dohyunKim0309/CNN_Accelerator/docs/address_map_winograd.png

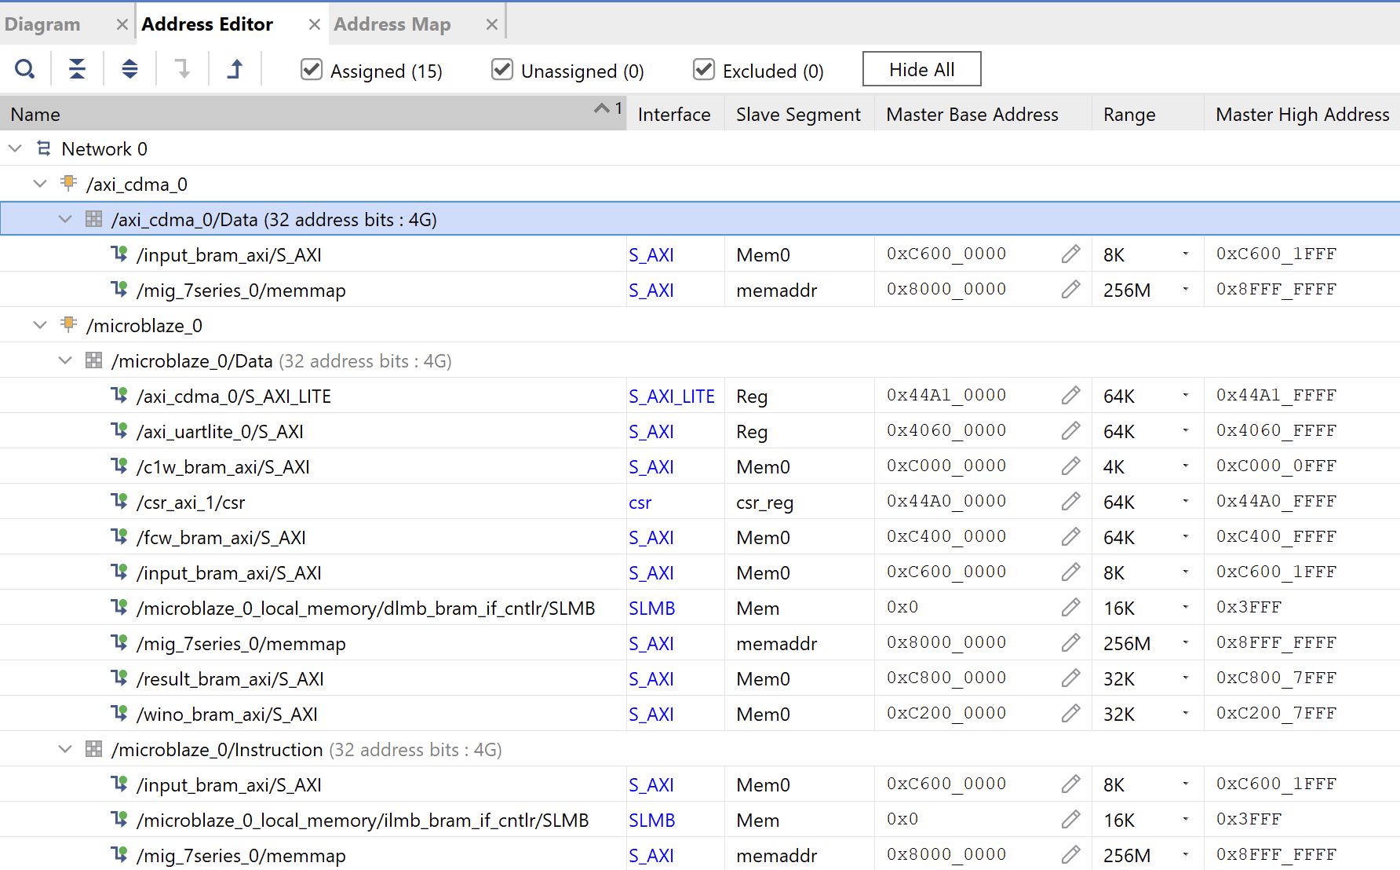
docs/address_map_winograd.png
