dohyunKim0309/CNN_Accelerator/docs/codebase_capture.png

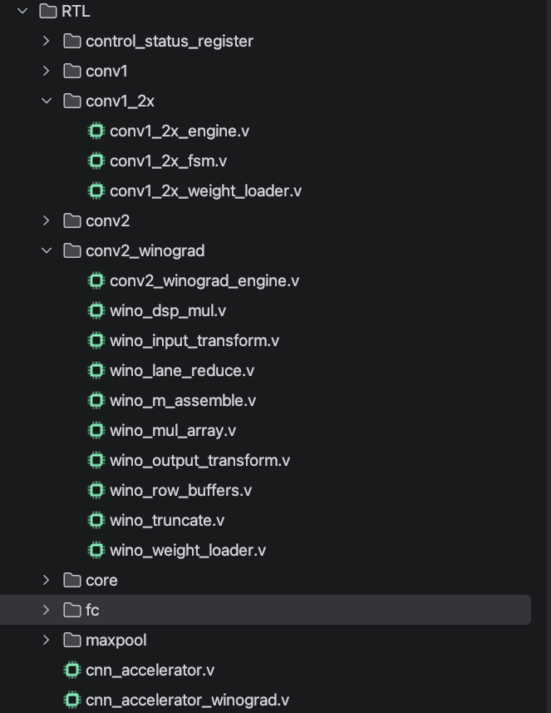
docs/codebase_capture.png
