dohyunKim0309/CNN_Accelerator/docs/ip_spec/wino_weight_bram/wino_weight_bram-basic.png

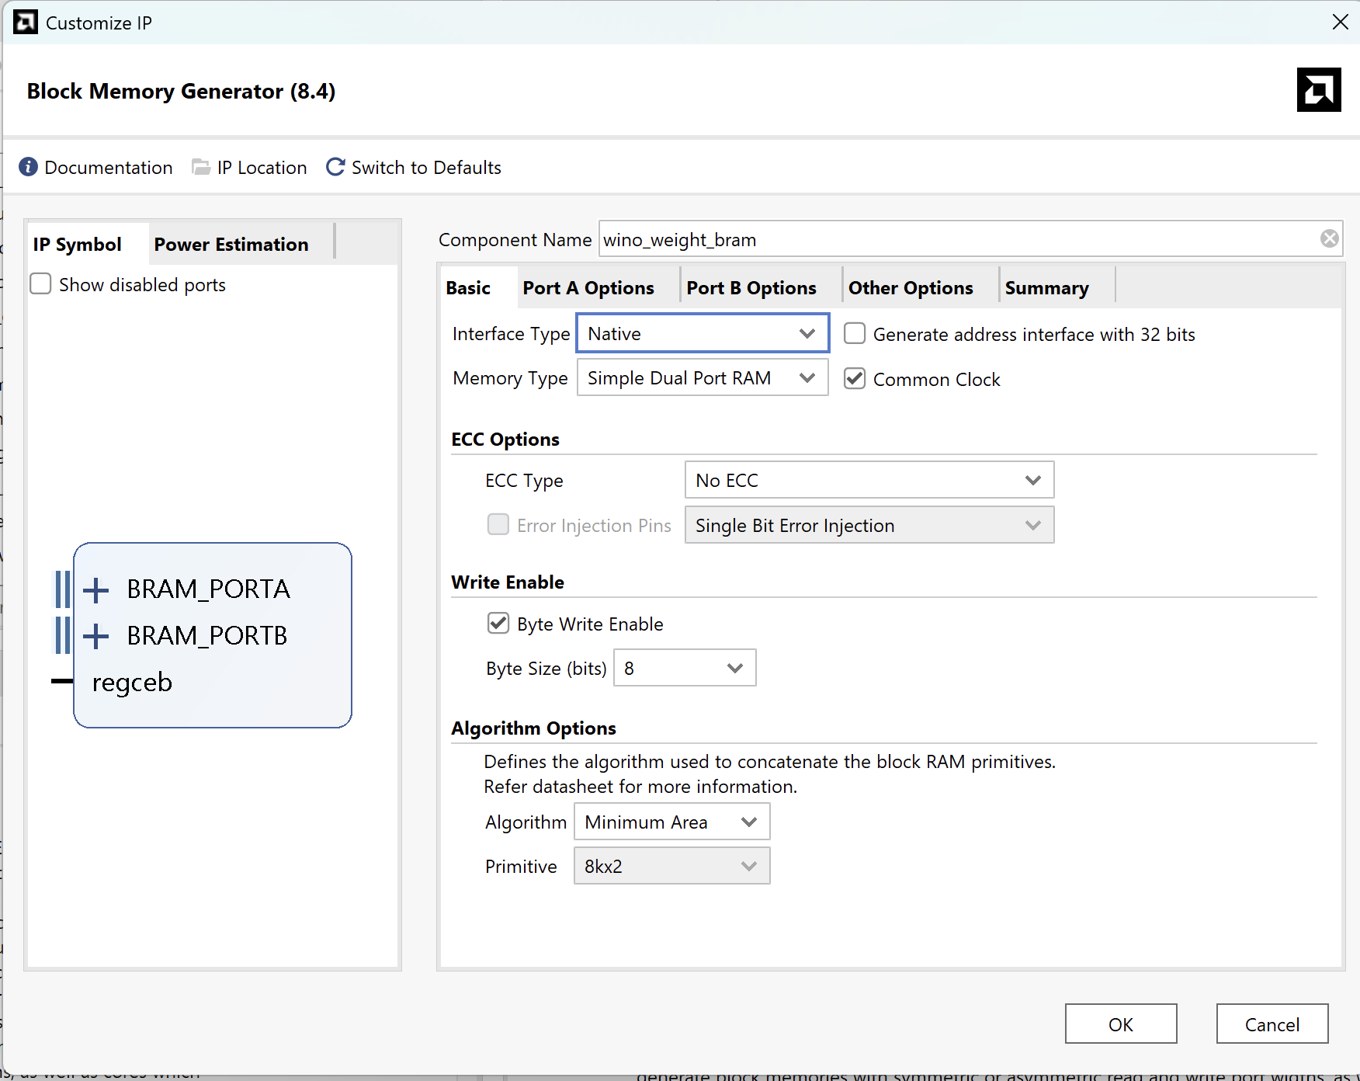
docs/ip_spec/wino_weight_bram/wino_weight_bram-basic.png
