dohyunKim0309/CNN_Accelerator/docs/ip_spec/wino_weight_bram/wino_weight_bram-portB.png

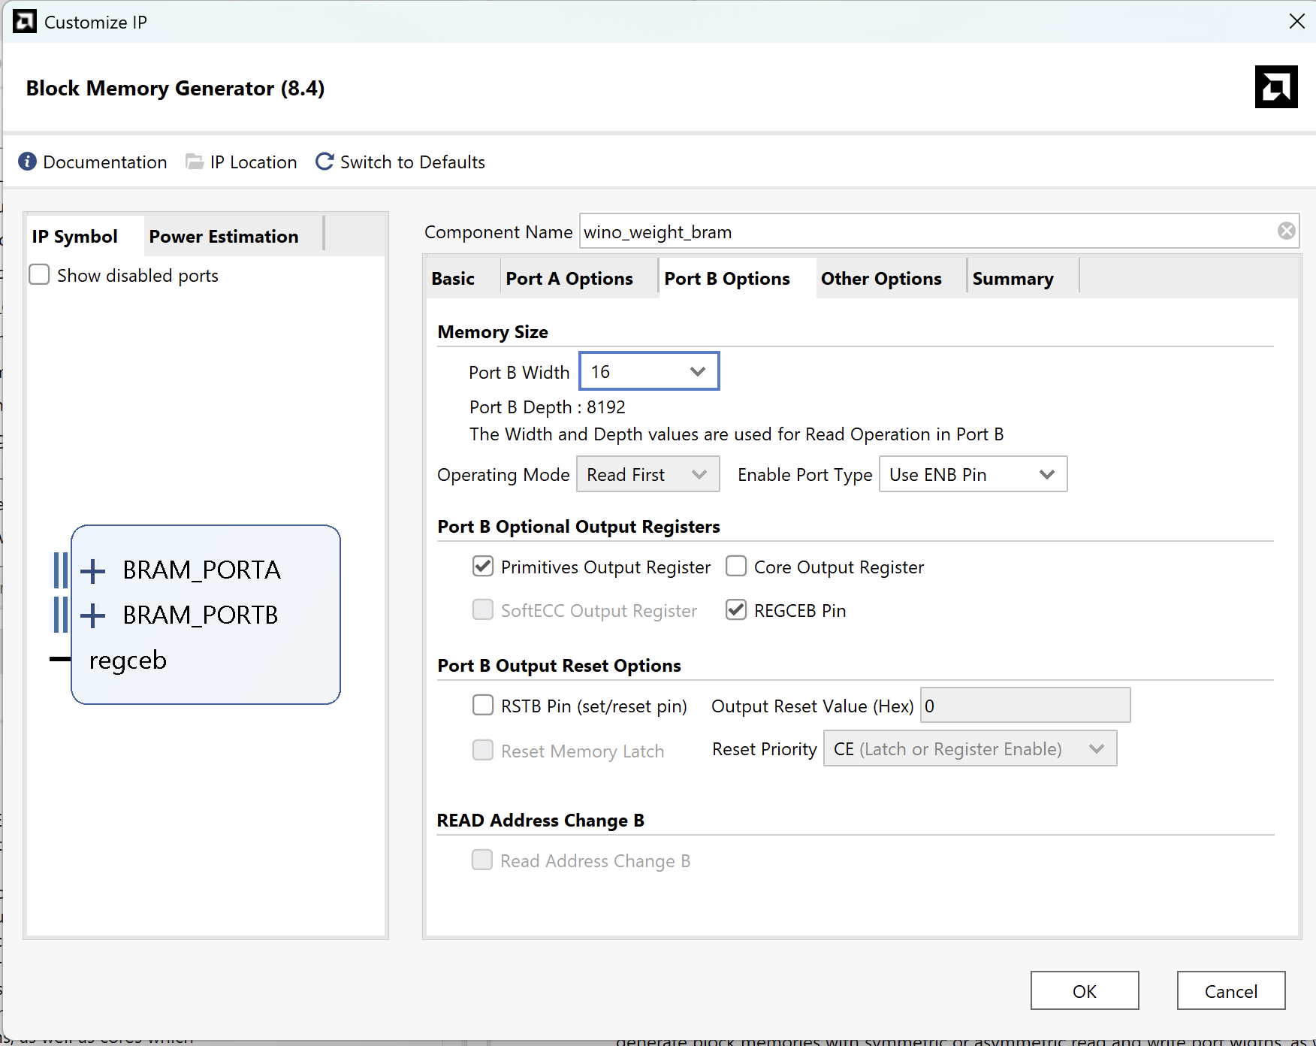
docs/ip_spec/wino_weight_bram/wino_weight_bram-portB.png
