dohyunKim0309/CNN_Accelerator/docs/MIG.png

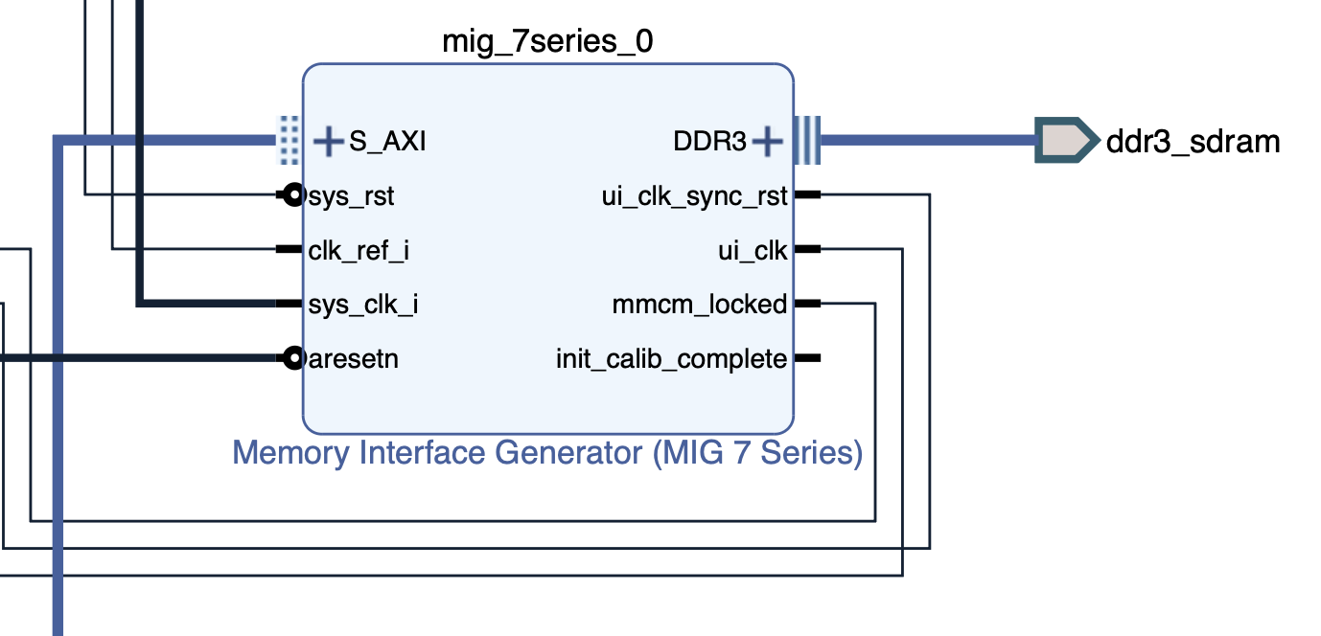
docs/MIG.png
