dohyunKim0309/CNN_Accelerator/docs/overclock/direct/timing/150_timing.png

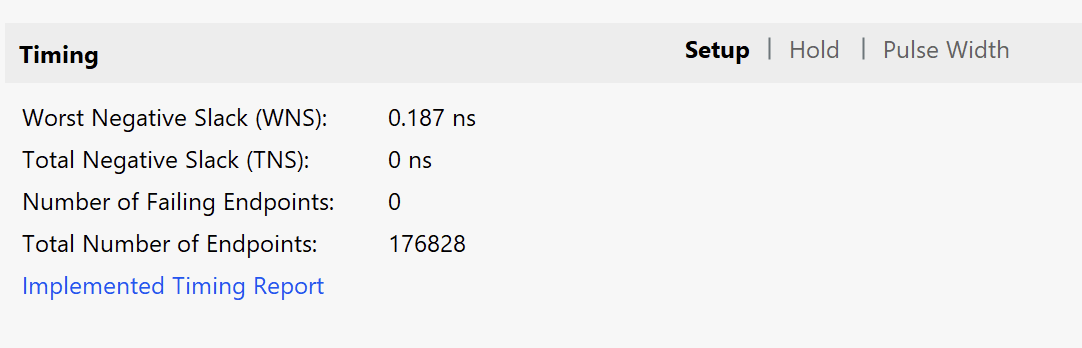
docs/overclock/direct/timing/150_timing.png
