dohyunKim0309/CNN_Accelerator/docs/overclock/direct/timing/final_power.png

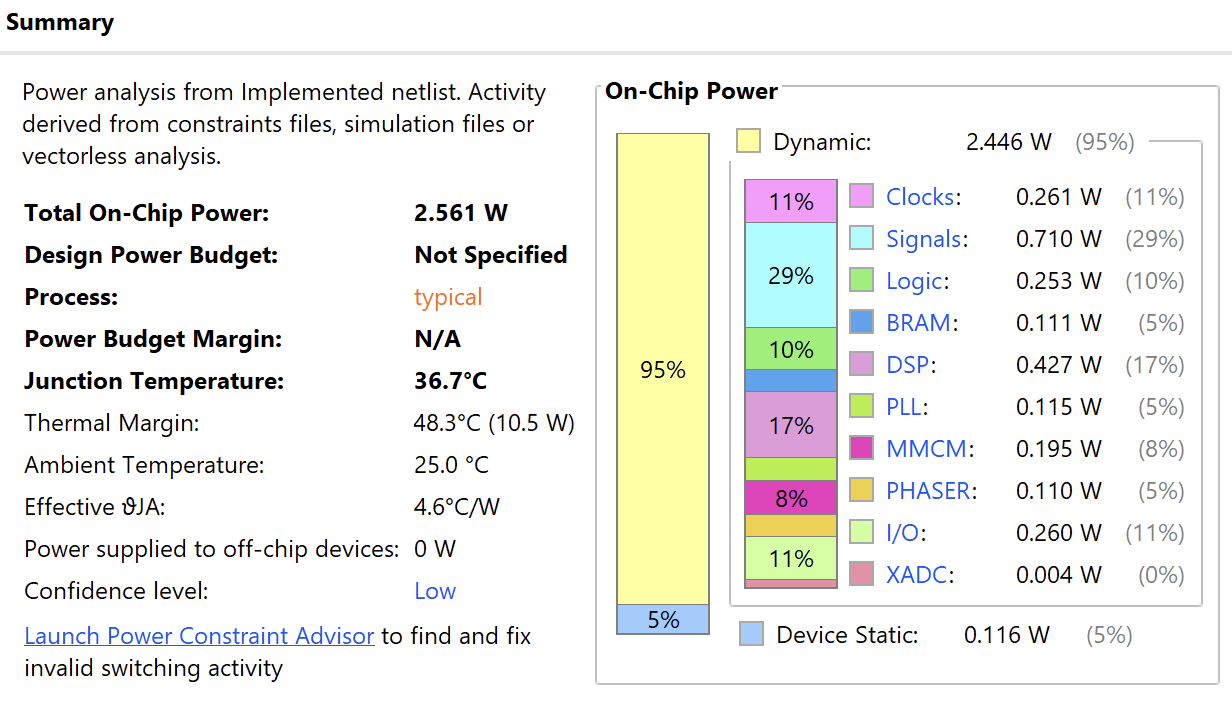
docs/overclock/direct/timing/final_power.png
