dohyunKim0309/CNN_Accelerator/docs/overclock/direct/timing/final_timing.png

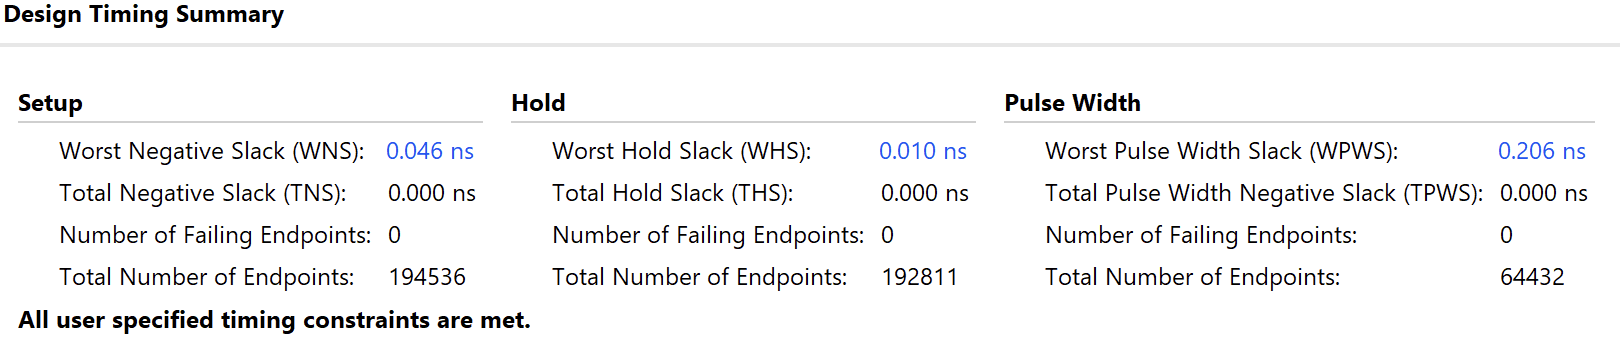
docs/overclock/direct/timing/final_timing.png
