dohyunKim0309/CNN_Accelerator/docs/overclock/winograd/03_route_wns-1.74_output-transform/스크린샷 2026-06-12 오전 12.46.09.png

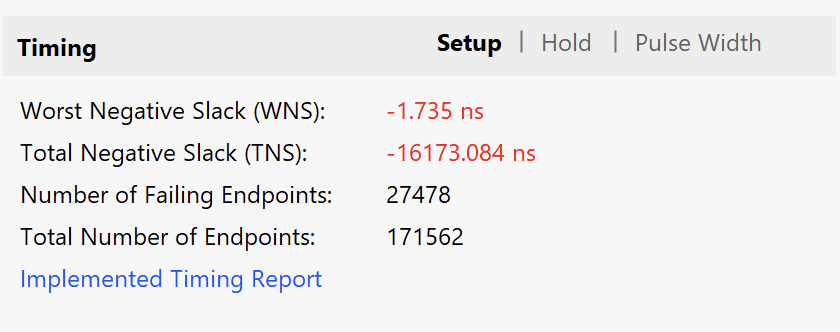
docs/overclock/winograd/03_route_wns-1.74_output-transform/스크린샷 2026-06-12 오전 12.46.09.png
