dohyunKim0309/CNN_Accelerator/docs/overclock/winograd/04_route_wns-0.41_wm-equiv-merge/스크린샷 2026-06-12 오전 2.36.51.png

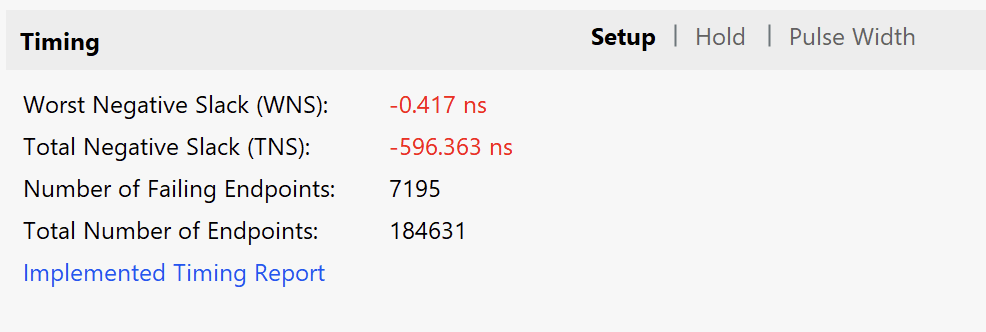
docs/overclock/winograd/04_route_wns-0.41_wm-equiv-merge/스크린샷 2026-06-12 오전 2.36.51.png
