dohyunKim0309/CNN_Accelerator/docs/overclock/winograd/winograd_171.42MHz_timing.png

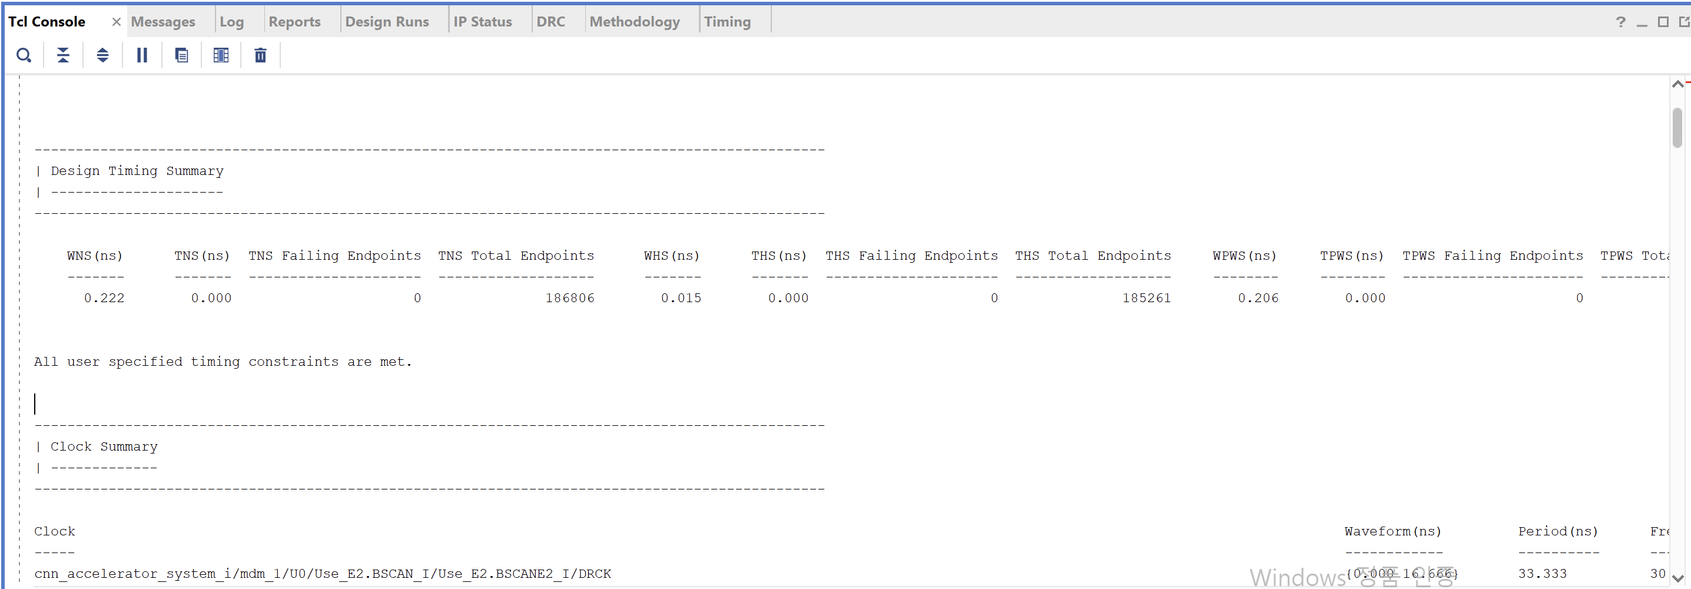
docs/overclock/winograd/winograd_171.42MHz_timing.png
