dohyunKim0309/CNN_Accelerator/docs/presentation_timing/01_trap.png

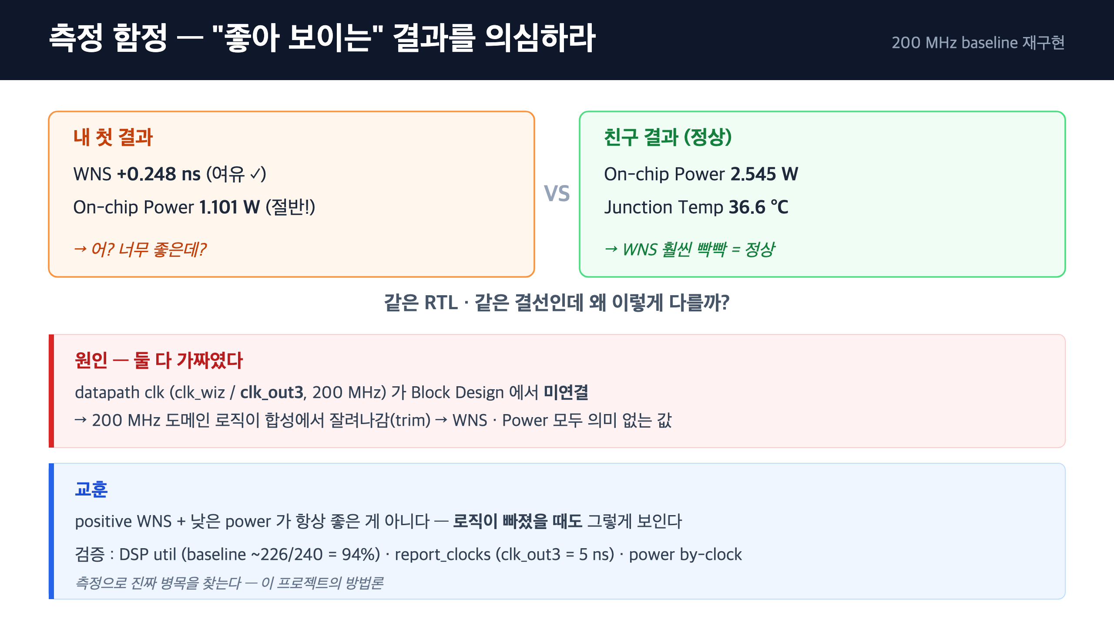
docs/presentation_timing/01_trap.png
