dohyunKim0309/CNN_Accelerator/docs/presentation_timing/02_bottleneck.png

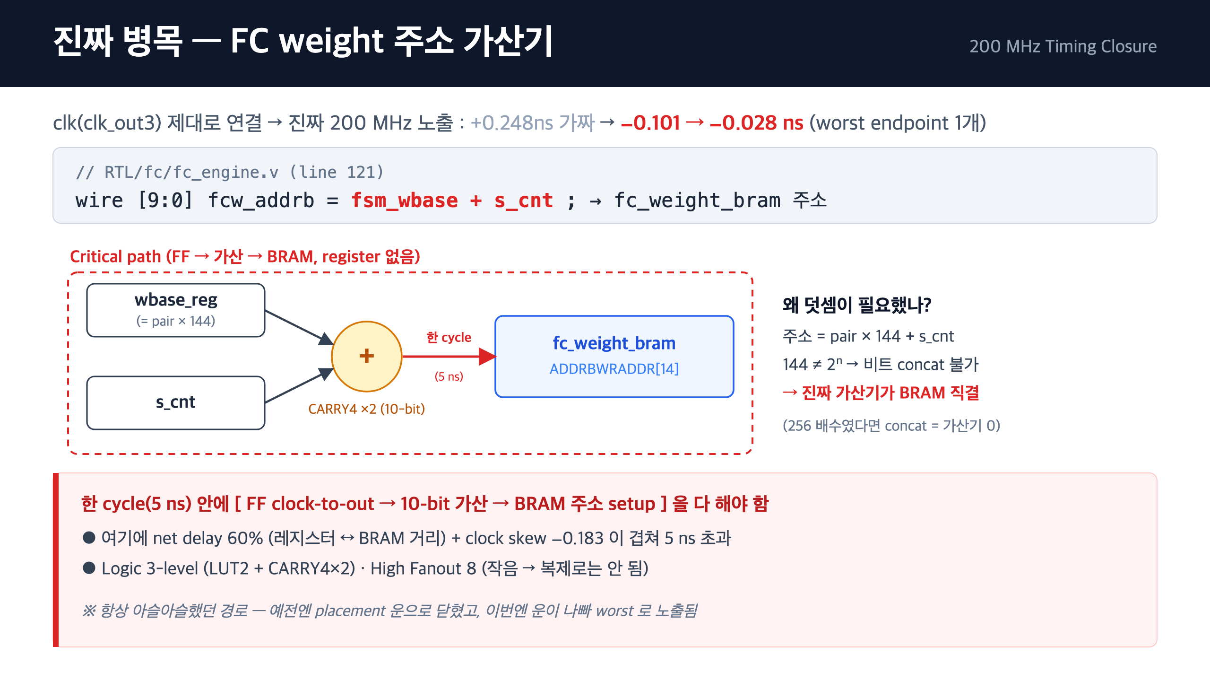
docs/presentation_timing/02_bottleneck.png
