dohyunKim0309/CNN_Accelerator/docs/UART_우회_DDR3.png

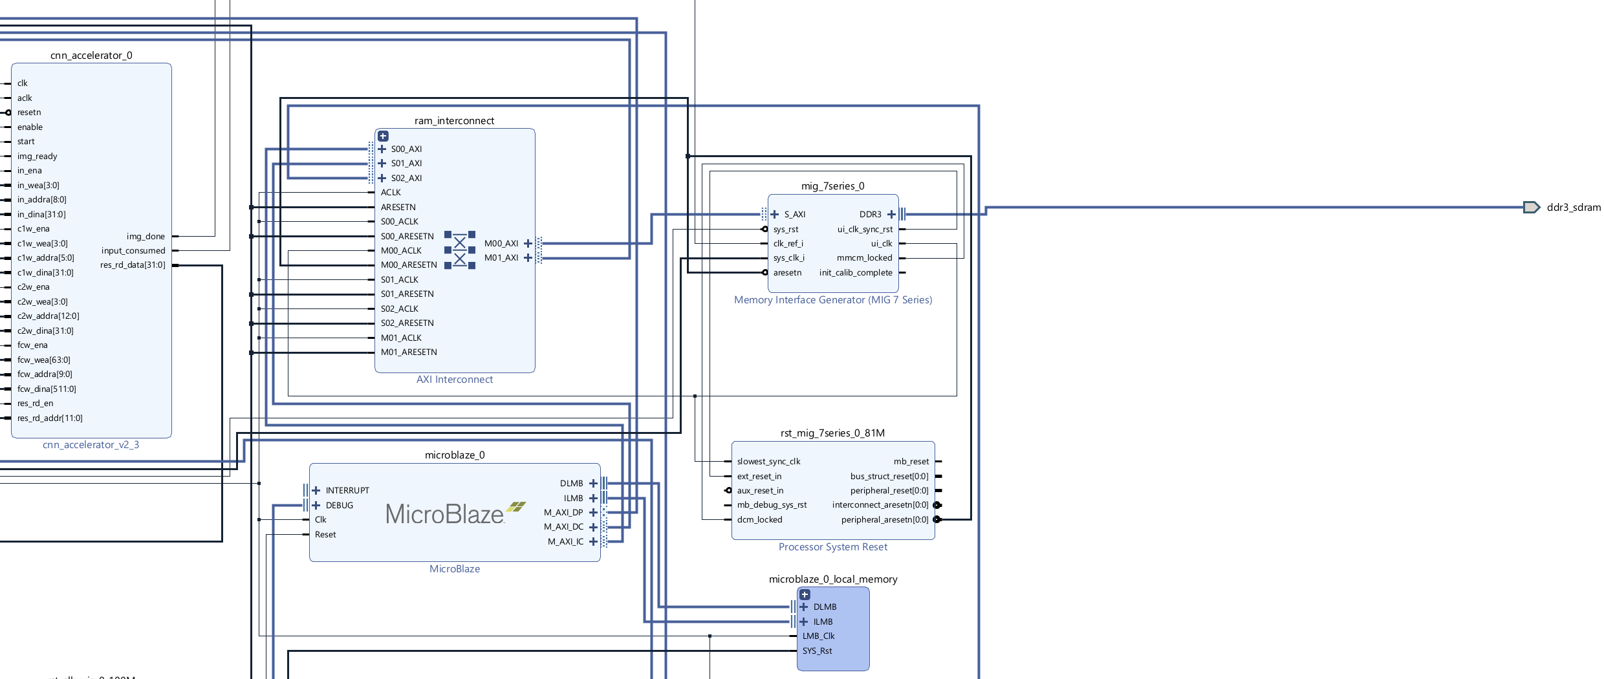
docs/UART_우회_DDR3.png
