dohyunKim0309/CNN_Accelerator/docs/winograd_utilization_stale.png

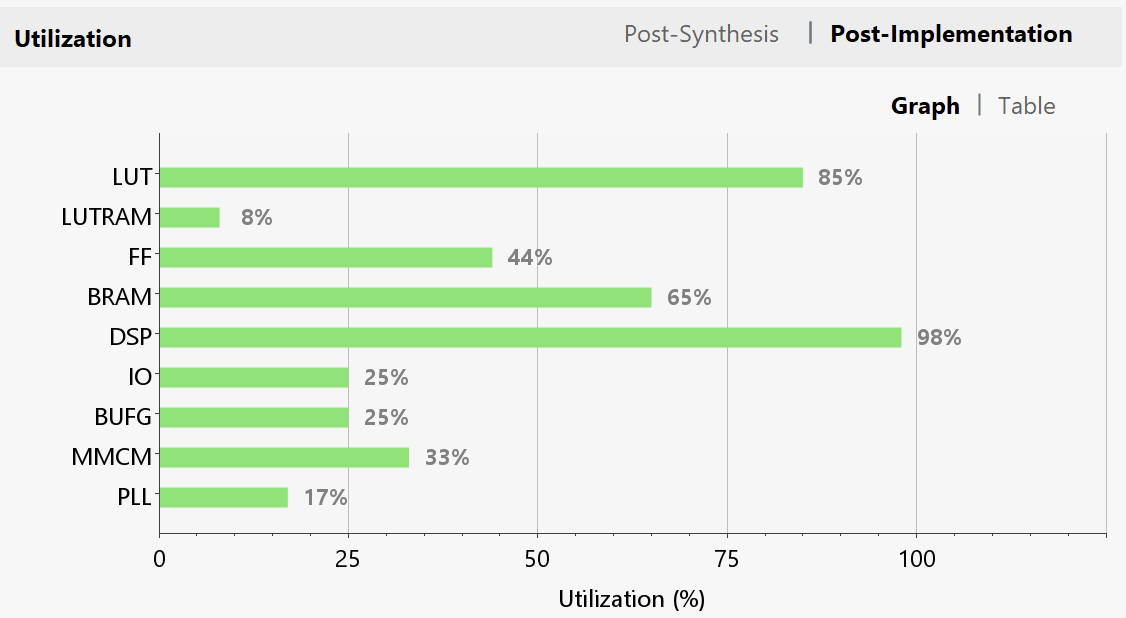
docs/winograd_utilization_stale.png
