dohyunKim0309/CNN_Accelerator/docs/result_01_sequential.png

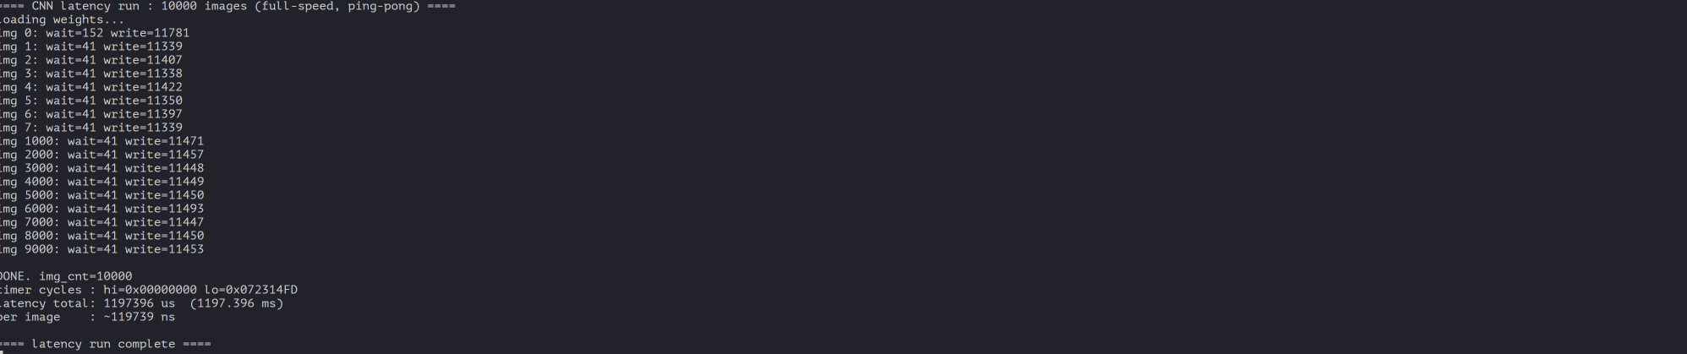
docs/result_01_sequential.png
