dohyunKim0309/CNN_Accelerator/docs/result_02(2)axi_burst.png

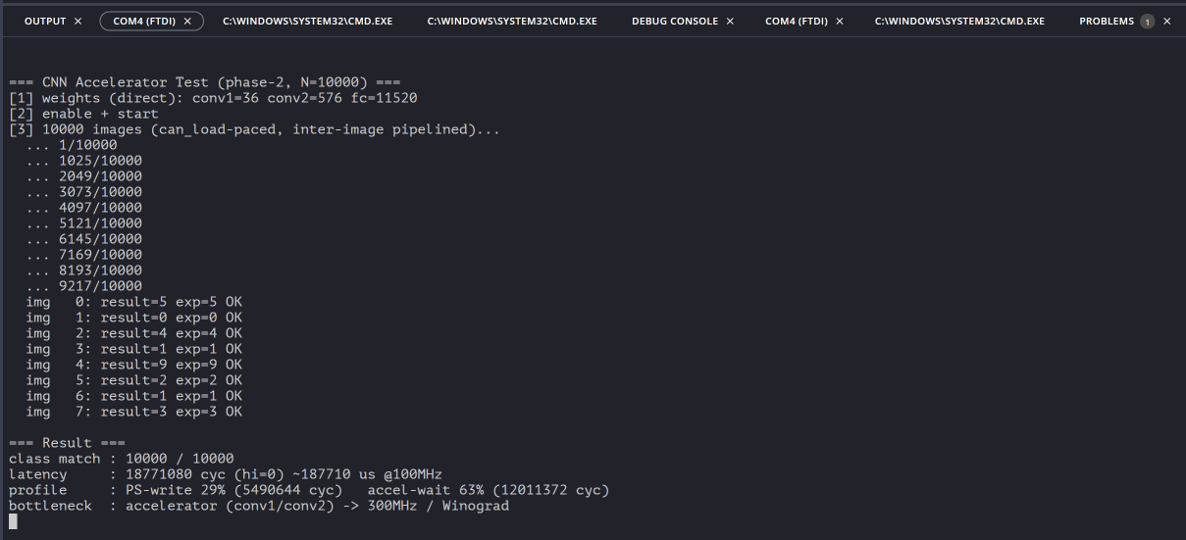
docs/result_02(2)axi_burst.png
