dohyunKim0309/CNN_Accelerator/docs/result_02_pipelining.png

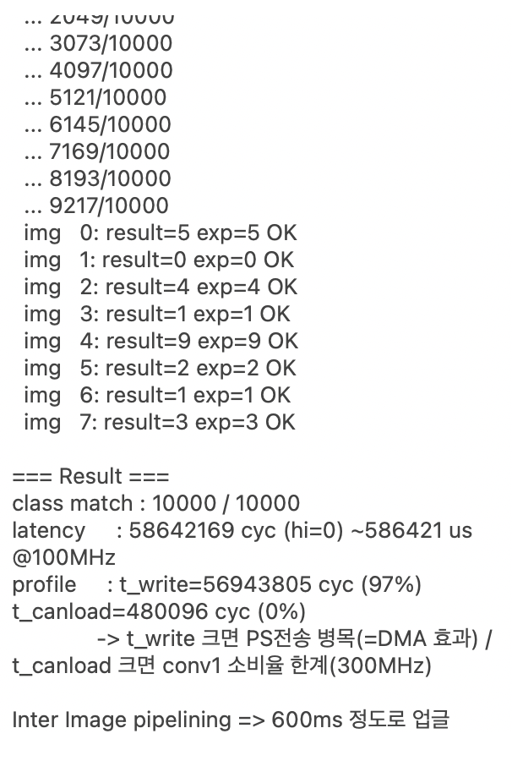
docs/result_02_pipelining.png
