dohyunKim0309/CNN_Accelerator/RTL/conv2_winograd/wino_input_transform.v

`timescale 1ns / 1ps
////////////////////////////////////////////////////////////////////////////////
// wino_input_transform.v  (자동생성: scripts/weights/winograd_gen.py)
//   복소수 Winograd F(4,3) 입력변환  V = Bᵀ·d·B  (per IC, 곱셈기 0개)
//   d(6×6 INT8) → 46 activation operand (B-port feed), canonical 순서:
//     [16 real pos: V_re] + [10 cmul pos: (V_re+V_im), V_re, V_im]
//   ★ 3-stage PIPELINE: stage1 t=Bᵀ·d → reg → stage2a 부분합 → reg →
//     stage2b 최종합+assembly.  a_flat = d_flat + 2 cycle (engine 정렬 +4 기준).
//   계수 {0,±1,±4} add/shift/neg only.
////////////////////////////////////////////////////////////////////////////////
module wino_input_transform #(parameter DW=8, VW=14) (
    input  wire             clk,
    input  wire [36*DW-1:0] d_flat,   // d[k][l] = d_flat[(k*6+l)*DW +: DW] (signed)
    output wire [46*VW-1:0] a_flat    // operand i = a_flat[i*VW +: VW] (signed, +2 cyc)
);
    wire signed [10:0] d [0:5][0:5];
    genvar gk, gl;
    generate for (gk=0; gk<6; gk=gk+1) for (gl=0; gl<6; gl=gl+1)
        assign d[gk][gl] = $signed(d_flat[(gk*6+gl)*DW +: DW]);
    endgenerate

    // stage1 (comb): t = Bᵀ·d   t[p][l] = Σ_k Bᵀ[p,k]·d[k][l]
    wire signed [10:0] tre_c [0:5][0:5];
    wire signed [10:0] tim_c [0:5][0:5];
    assign tre_c[0][0] = (d[0][0] <<< 2) - (d[4][0] <<< 2);
    assign tim_c[0][0] = 11'sd0;
    assign tre_c[0][1] = (d[0][1] <<< 2) - (d[4][1] <<< 2);
    assign tim_c[0][1] = 11'sd0;
    assign tre_c[0][2] = (d[0][2] <<< 2) - (d[4][2] <<< 2);
    assign tim_c[0][2] = 11'sd0;
    assign tre_c[0][3] = (d[0][3] <<< 2) - (d[4][3] <<< 2);
    assign tim_c[0][3] = 11'sd0;
    assign tre_c[0][4] = (d[0][4] <<< 2) - (d[4][4] <<< 2);
    assign tim_c[0][4] = 11'sd0;
    assign tre_c[0][5] = (d[0][5] <<< 2) - (d[4][5] <<< 2);
    assign tim_c[0][5] = 11'sd0;
    assign tre_c[1][0] = d[1][0] + d[2][0] + d[3][0] + d[4][0];
    assign tim_c[1][0] = 11'sd0;
    assign tre_c[1][1] = d[1][1] + d[2][1] + d[3][1] + d[4][1];
    assign tim_c[1][1] = 11'sd0;
    assign tre_c[1][2] = d[1][2] + d[2][2] + d[3][2] + d[4][2];
    assign tim_c[1][2] = 11'sd0;
    assign tre_c[1][3] = d[1][3] + d[2][3] + d[3][3] + d[4][3];
    assign tim_c[1][3] = 11'sd0;
    assign tre_c[1][4] = d[1][4] + d[2][4] + d[3][4] + d[4][4];
    assign tim_c[1][4] = 11'sd0;
    assign tre_c[1][5] = d[1][5] + d[2][5] + d[3][5] + d[4][5];
    assign tim_c[1][5] = 11'sd0;
    assign tre_c[2][0] = -d[1][0] + d[2][0] - d[3][0] + d[4][0];
    assign tim_c[2][0] = 11'sd0;
    assign tre_c[2][1] = -d[1][1] + d[2][1] - d[3][1] + d[4][1];
    assign tim_c[2][1] = 11'sd0;
    assign tre_c[2][2] = -d[1][2] + d[2][2] - d[3][2] + d[4][2];
    assign tim_c[2][2] = 11'sd0;
    assign tre_c[2][3] = -d[1][3] + d[2][3] - d[3][3] + d[4][3];
    assign tim_c[2][3] = 11'sd0;
    assign tre_c[2][4] = -d[1][4] + d[2][4] - d[3][4] + d[4][4];
    assign tim_c[2][4] = 11'sd0;
    assign tre_c[2][5] = -d[1][5] + d[2][5] - d[3][5] + d[4][5];
    assign tim_c[2][5] = 11'sd0;
    assign tre_c[3][0] = -d[2][0] + d[4][0];
    assign tim_c[3][0] = -d[1][0] + d[3][0];
    assign tre_c[3][1] = -d[2][1] + d[4][1];
    assign tim_c[3][1] = -d[1][1] + d[3][1];
    assign tre_c[3][2] = -d[2][2] + d[4][2];
    assign tim_c[3][2] = -d[1][2] + d[3][2];
    assign tre_c[3][3] = -d[2][3] + d[4][3];
    assign tim_c[3][3] = -d[1][3] + d[3][3];
    assign tre_c[3][4] = -d[2][4] + d[4][4];
    assign tim_c[3][4] = -d[1][4] + d[3][4];
    assign tre_c[3][5] = -d[2][5] + d[4][5];
    assign tim_c[3][5] = -d[1][5] + d[3][5];
    assign tre_c[4][0] = -d[2][0] + d[4][0];
    assign tim_c[4][0] = d[1][0] - d[3][0];
    assign tre_c[4][1] = -d[2][1] + d[4][1];
    assign tim_c[4][1] = d[1][1] - d[3][1];
    assign tre_c[4][2] = -d[2][2] + d[4][2];
    assign tim_c[4][2] = d[1][2] - d[3][2];
    assign tre_c[4][3] = -d[2][3] + d[4][3];
    assign tim_c[4][3] = d[1][3] - d[3][3];
    assign tre_c[4][4] = -d[2][4] + d[4][4];
    assign tim_c[4][4] = d[1][4] - d[3][4];
    assign tre_c[4][5] = -d[2][5] + d[4][5];
    assign tim_c[4][5] = d[1][5] - d[3][5];
    assign tre_c[5][0] = -(d[1][0] <<< 2) + (d[5][0] <<< 2);
    assign tim_c[5][0] = 11'sd0;
    assign tre_c[5][1] = -(d[1][1] <<< 2) + (d[5][1] <<< 2);
    assign tim_c[5][1] = 11'sd0;
    assign tre_c[5][2] = -(d[1][2] <<< 2) + (d[5][2] <<< 2);
    assign tim_c[5][2] = 11'sd0;
    assign tre_c[5][3] = -(d[1][3] <<< 2) + (d[5][3] <<< 2);
    assign tim_c[5][3] = 11'sd0;
    assign tre_c[5][4] = -(d[1][4] <<< 2) + (d[5][4] <<< 2);
    assign tim_c[5][4] = 11'sd0;
    assign tre_c[5][5] = -(d[1][5] <<< 2) + (d[5][5] <<< 2);
    assign tim_c[5][5] = 11'sd0;

    // stage1→2 register (t)
    reg signed [10:0] tre [0:5][0:5];
    reg signed [10:0] tim [0:5][0:5];
    integer rp, rl;
    always @(posedge clk) for (rp=0; rp<6; rp=rp+1) for (rl=0; rl<6; rl=rl+1) begin
        tre[rp][rl] <= tre_c[rp][rl];
        tim[rp][rl] <= tim_c[rp][rl];
    end

    // stage2a (comb): V = t·B 부분합 (2-term)   V[p][q] = Σ_l t[p][l]·Bᵀ[q,l]
    wire signed [13:0] vre_0_0_p0 = (tre[0][0] <<< 2) - (tre[0][4] <<< 2);
    wire signed [13:0] vre_0_1_p0 = tre[0][1] + tre[0][2];
    wire signed [13:0] vre_0_1_p1 = tre[0][3] + tre[0][4];
    wire signed [13:0] vre_0_2_p0 = -tre[0][1] + tre[0][2];
    wire signed [13:0] vre_0_2_p1 = -tre[0][3] + tre[0][4];
    wire signed [13:0] vre_0_3_p0 = tim[0][1] - tre[0][2];
    wire signed [13:0] vre_0_3_p1 = -tim[0][3] + tre[0][4];
    wire signed [13:0] vre_0_5_p0 = -(tre[0][1] <<< 2) + (tre[0][5] <<< 2);
    wire signed [13:0] vre_1_0_p0 = (tre[1][0] <<< 2) - (tre[1][4] <<< 2);
    wire signed [13:0] vre_1_1_p0 = tre[1][1] + tre[1][2];
    wire signed [13:0] vre_1_1_p1 = tre[1][3] + tre[1][4];
    wire signed [13:0] vre_1_2_p0 = -tre[1][1] + tre[1][2];
    wire signed [13:0] vre_1_2_p1 = -tre[1][3] + tre[1][4];
    wire signed [13:0] vre_1_3_p0 = tim[1][1] - tre[1][2];
    wire signed [13:0] vre_1_3_p1 = -tim[1][3] + tre[1][4];
    wire signed [13:0] vre_1_5_p0 = -(tre[1][1] <<< 2) + (tre[1][5] <<< 2);
    wire signed [13:0] vre_2_0_p0 = (tre[2][0] <<< 2) - (tre[2][4] <<< 2);
    wire signed [13:0] vre_2_1_p0 = tre[2][1] + tre[2][2];
    wire signed [13:0] vre_2_1_p1 = tre[2][3] + tre[2][4];
    wire signed [13:0] vre_2_2_p0 = -tre[2][1] + tre[2][2];
    wire signed [13:0] vre_2_2_p1 = -tre[2][3] + tre[2][4];
    wire signed [13:0] vre_2_3_p0 = tim[2][1] - tre[2][2];
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
    assign a_flat[33*VW +: VW] = vim_3_2;  // cmul (3,2) d
    assign a_flat[34*VW +: VW] = vcd_3_3_p0_q + vcd_3_3_p1_q + vcd_3_3_p2_q + vcd_3_3_p3_q;  // cmul (3,3) c+d (전용 부분합)
    assign a_flat[35*VW +: VW] = vre_3_3;  // cmul (3,3) c
    assign a_flat[36*VW +: VW] = vim_3_3;  // cmul (3,3) d
    assign a_flat[37*VW +: VW] = vcd_3_4_p0_q + vcd_3_4_p1_q + vcd_3_4_p2_q + vcd_3_4_p3_q;  // cmul (3,4) c+d (전용 부분합)
    assign a_flat[38*VW +: VW] = vre_3_4;  // cmul (3,4) c
    assign a_flat[39*VW +: VW] = vim_3_4;  // cmul (3,4) d
    assign a_flat[40*VW +: VW] = vcd_3_5_p0_q + vcd_3_5_p1_q;  // cmul (3,5) c+d (전용 부분합)
    assign a_flat[41*VW +: VW] = vre_3_5;  // cmul (3,5) c
    assign a_flat[42*VW +: VW] = vim_3_5;  // cmul (3,5) d
    assign a_flat[43*VW +: VW] = vcd_5_3_p0_q + vcd_5_3_p1_q + vcd_5_3_p2_q + vcd_5_3_p3_q;  // cmul (5,3) c+d (전용 부분합)
    assign a_flat[44*VW +: VW] = vre_5_3;  // cmul (5,3) c
    assign a_flat[45*VW +: VW] = vim_5_3;  // cmul (5,3) d
endmodule
