dohyunKim0309/CNN_Accelerator/RTL/conv2_winograd/wino_output_transform.v

`timescale 1ns / 1ps
////////////////////////////////////////////////////////////////////////////////
// wino_output_transform.v  (자동생성: scripts/weights/winograd_gen.py)
//   복소수 Winograd F(4,3) 출력변환  Y16 = Aᵀ·M·A  (per OC,tile, 곱셈기 0개)
//   M(6×6 complex, 켤레 포함 전체) → Y16(4×4 real). imag 은 수학적으로 0.
//   ★ 4-stage PIPELINE: in_valid@T → 1a 부분합(reg) → 1b y=Σ(reg) →
//      2a 부분합(reg) → 2b Y16=Σ(reg) → y16_flat/out_valid@T+4.
//      stage당 add ≤2단 (200MHz).  계수 {0,±1} add/sub/neg only.
//   out = sat(Y16>>>14)+ReLU 은 wino_truncate 에서 (= direct conv bit-exact).
////////////////////////////////////////////////////////////////////////////////
module wino_output_transform #(parameter MW=25, YW=28) (
    input  wire             clk,
    input  wire             in_valid,  // M 유효 pulse
    input  wire [36*MW-1:0] mre_flat,  // M_re[p][q] = [(p*6+q)*MW +: MW] (signed)
    input  wire [36*MW-1:0] mim_flat,  // M_im[p][q]
    output reg              out_valid, // Y16 유효 pulse (in_valid+4)
    output reg  [16*YW-1:0] y16_flat   // Y16[i][j] = [(i*4+j)*YW +: YW] (signed, real)
);
    wire signed [24:0] mre [0:5][0:5];
    wire signed [24:0] mim [0:5][0:5];
    genvar gp, gq;
    generate for (gp=0; gp<6; gp=gp+1) for (gq=0; gq<6; gq=gq+1) begin
        assign mre[gp][gq] = $signed(mre_flat[(gp*6+gq)*MW +: MW]);
        assign mim[gp][gq] = $signed(mim_flat[(gp*6+gq)*MW +: MW]);
    end endgenerate

    // stage1a (comb): y = Aᵀ·M 부분합 (2-term)   y[i][l] = Σ_p Aᵀ[i,p]·M[p][l]
    wire signed [27:0] yre_0_0_p0 = mre[0][0] + mre[1][0];
    wire signed [27:0] yre_0_0_p1 = mre[2][0] + mre[3][0];
    wire signed [27:0] yre_0_0_p2 = mre[4][0];
    wire signed [27:0] yim_0_0_p0 = mim[0][0] + mim[1][0];
    wire signed [27:0] yim_0_0_p1 = mim[2][0] + mim[3][0];
    wire signed [27:0] yim_0_0_p2 = mim[4][0];
    wire signed [27:0] yre_0_1_p0 = mre[0][1] + mre[1][1];
    wire signed [27:0] yre_0_1_p1 = mre[2][1] + mre[3][1];
    wire signed [27:0] yre_0_1_p2 = mre[4][1];
    wire signed [27:0] yim_0_1_p0 = mim[0][1] + mim[1][1];
    wire signed [27:0] yim_0_1_p1 = mim[2][1] + mim[3][1];
    wire signed [27:0] yim_0_1_p2 = mim[4][1];
    wire signed [27:0] yre_0_2_p0 = mre[0][2] + mre[1][2];
    wire signed [27:0] yre_0_2_p1 = mre[2][2] + mre[3][2];
    wire signed [27:0] yre_0_2_p2 = mre[4][2];
    wire signed [27:0] yim_0_2_p0 = mim[0][2] + mim[1][2];
    wire signed [27:0] yim_0_2_p1 = mim[2][2] + mim[3][2];
    wire signed [27:0] yim_0_2_p2 = mim[4][2];
    wire signed [27:0] yre_0_3_p0 = mre[0][3] + mre[1][3];
    wire signed [27:0] yre_0_3_p1 = mre[2][3] + mre[3][3];
    wire signed [27:0] yre_0_3_p2 = mre[4][3];
    wire signed [27:0] yim_0_3_p0 = mim[0][3] + mim[1][3];
    wire signed [27:0] yim_0_3_p1 = mim[2][3] + mim[3][3];
    wire signed [27:0] yim_0_3_p2 = mim[4][3];
    wire signed [27:0] yre_0_4_p0 = mre[0][4] + mre[1][4];
    wire signed [27:0] yre_0_4_p1 = mre[2][4] + mre[3][4];
    wire signed [27:0] yre_0_4_p2 = mre[4][4];
    wire signed [27:0] yim_0_4_p0 = mim[0][4] + mim[1][4];
    wire signed [27:0] yim_0_4_p1 = mim[2][4] + mim[3][4];
    wire signed [27:0] yim_0_4_p2 = mim[4][4];
    wire signed [27:0] yre_0_5_p0 = mre[0][5] + mre[1][5];
    wire signed [27:0] yre_0_5_p1 = mre[2][5] + mre[3][5];
    wire signed [27:0] yre_0_5_p2 = mre[4][5];
    wire signed [27:0] yim_0_5_p0 = mim[0][5] + mim[1][5];
    wire signed [27:0] yim_0_5_p1 = mim[2][5] + mim[3][5];
    wire signed [27:0] yim_0_5_p2 = mim[4][5];
    wire signed [27:0] yre_1_0_p0 = mre[1][0] - mre[2][0];
    wire signed [27:0] yre_1_0_p1 = -mim[3][0] + mim[4][0];
    wire signed [27:0] yim_1_0_p0 = mim[1][0] - mim[2][0];
    wire signed [27:0] yim_1_0_p1 = mre[3][0] - mre[4][0];
    wire signed [27:0] yre_1_1_p0 = mre[1][1] - mre[2][1];
    wire signed [27:0] yre_1_1_p1 = -mim[3][1] + mim[4][1];
    wire signed [27:0] yim_1_1_p0 = mim[1][1] - mim[2][1];
    wire signed [27:0] yim_1_1_p1 = mre[3][1] - mre[4][1];
    wire signed [27:0] yre_1_2_p0 = mre[1][2] - mre[2][2];
    wire signed [27:0] yre_1_2_p1 = -mim[3][2] + mim[4][2];
    wire signed [27:0] yim_1_2_p0 = mim[1][2] - mim[2][2];
    wire signed [27:0] yim_1_2_p1 = mre[3][2] - mre[4][2];
    wire signed [27:0] yre_1_3_p0 = mre[1][3] - mre[2][3];
    wire signed [27:0] yre_1_3_p1 = -mim[3][3] + mim[4][3];
    wire signed [27:0] yim_1_3_p0 = mim[1][3] - mim[2][3];
    wire signed [27:0] yim_1_3_p1 = mre[3][3] - mre[4][3];
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
        y16_3_0_p1_q <= y16_3_0_p1;
        y16_3_0_p2_q <= y16_3_0_p2;
        y16_3_1_p0_q <= y16_3_1_p0;
        y16_3_1_p1_q <= y16_3_1_p1;
        y16_3_2_p0_q <= y16_3_2_p0;
        y16_3_2_p1_q <= y16_3_2_p1;
        y16_3_3_p0_q <= y16_3_3_p0;
        y16_3_3_p1_q <= y16_3_3_p1;
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
    end

    // stage2b: Y16 = Σ부분합 → register (y16_flat) + out_valid
    always @(posedge clk) begin
        out_valid <= v3;
        y16_flat[0*YW +: YW] <= y16_0_0_p0_q + y16_0_0_p1_q + y16_0_0_p2_q;
        y16_flat[1*YW +: YW] <= y16_0_1_p0_q + y16_0_1_p1_q;
        y16_flat[2*YW +: YW] <= y16_0_2_p0_q + y16_0_2_p1_q;
        y16_flat[3*YW +: YW] <= y16_0_3_p0_q + y16_0_3_p1_q + y16_0_3_p2_q;
        y16_flat[4*YW +: YW] <= y16_1_0_p0_q + y16_1_0_p1_q + y16_1_0_p2_q;
        y16_flat[5*YW +: YW] <= y16_1_1_p0_q + y16_1_1_p1_q;
        y16_flat[6*YW +: YW] <= y16_1_2_p0_q + y16_1_2_p1_q;
        y16_flat[7*YW +: YW] <= y16_1_3_p0_q + y16_1_3_p1_q + y16_1_3_p2_q;
        y16_flat[8*YW +: YW] <= y16_2_0_p0_q + y16_2_0_p1_q + y16_2_0_p2_q;
        y16_flat[9*YW +: YW] <= y16_2_1_p0_q + y16_2_1_p1_q;
        y16_flat[10*YW +: YW] <= y16_2_2_p0_q + y16_2_2_p1_q;
        y16_flat[11*YW +: YW] <= y16_2_3_p0_q + y16_2_3_p1_q + y16_2_3_p2_q;
        y16_flat[12*YW +: YW] <= y16_3_0_p0_q + y16_3_0_p1_q + y16_3_0_p2_q;
        y16_flat[13*YW +: YW] <= y16_3_1_p0_q + y16_3_1_p1_q;
        y16_flat[14*YW +: YW] <= y16_3_2_p0_q + y16_3_2_p1_q;
        y16_flat[15*YW +: YW] <= y16_3_3_p0_q + y16_3_3_p1_q + y16_3_3_p2_q;
    end
endmodule
