dohyunKim0309/CNN_Accelerator/(commit log)

2026-05-18 실제 MNIST 데이터 넣었을 때 정확도가 9%(거의 랜덤)이던 문제 해결
2026-05-20 docs 구조 변경
2026-05-20 DSP SIMD Packing 알고리즘 문서 추가
2026-05-20 cowork_guide.md 추가
2026-05-22 conv2 초안 작성, SIMD packing 문서 개선
2026-06-09 revert cnn accelerator top module, backup winograd version
    [cnn_accelerator_winograd.v]
2026-06-11 fix routing problem in winograd cnn accelerator
    [conv2_winograd_engine.v, wino_mul_array.v]
2026-06-19 overclock(winograd): conv2 timing MET at 171.43MHz via P&R over-constrain
    winograd conv2 closes at 171.43MHz (clk_out3 +0.337, WNS +0.222, 0 failing EP).
    The lever = P&R over-constrain (set_clock_uncertainty) forcing the placer to conv2's
    ~5.1ns routing floor; lowering the clock alone didn't help (router fills the budget).
    200MHz unreachable: conv2 IT-scatter floor (~5.1ns) > 5.0ns.
    - floorplan dead-end (76% LUT density + reduce gathers distributed DSP lanes -> compaction intrinsic-impossible)
    - bisect reverted (Vivado churn worsened Fmax); preserved in conv2_winograd_engine.bisect.bak
    - 188MHz = clk_wiz silent snap (requested != actual); VCO -1 limit 1200 (DS181) -> 171.43 ceiling
    - docs: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
    [Arty-a7-100-Master_v2.xdc, cnn_accelerator_winograd.v, conv1_2x_engine.v, conv2_winograd_engine.v, tb_cnn_accelerator_winograd_multi.v, tb_system_axi_winograd_multi_2clk.v, tb_wino_mul_array.v, wino_input_transform.v]
2026-06-19 report: finalize Typst sections + figures, add code-level winograd doc
    - 04_impl_winograd: add counter-driven FSM section, cycle budget table
    (1348 cyc/img), tile timing table; fix latency numbers (issue+11, 1348)
    - 06_results: replace placeholders with maxpool/fc unit-TB results (conv2
    unit-TB dropped); conv1 dropped
    - appendix: add Appendix C (team collaboration, branch strategy, repo URL)
    - docs/winograd: add conv2_winograd_codelevel_report.md (RTL-verified)
    - add report figures, vivado over/de-constrain tcl
    [conv2_winograd_engine_mpipe.v]
2026-06-20 fix(tb): conv2/conv1_conv2 single c2pool readback L=1 -> L=2
    c2pool BMG is L=2 (300MHz overclock) but compare tasks sampled at L=1
    (expected[i-1]) -> off-by-one got[N]==exp[N-1]. Engine output correct;
    readback now uses expected[i-2], loop 0..577. Both PASS 0/576.
    [tb_conv1_conv2.v, tb_conv2_engine.v]
2026-06-20 feat(tb): conv1 standalone multi-image handshake stress TB
    Random-speed producer/consumer drive conv1 via real prior_wdone trigger
    (matches cnn_accelerator.v top). N=40 bit-exact PASS, 0 protocol violations,
    prod_sat=39 cons_sat=31 (both backpressure directions exercised). Validates
    conv1 bank_sel_pipe race fix under random pacing. Add DATA_IMAGES param to
    BFM array sizing (silences readmemh over-read warning; data=100 img).
    [handshake_bfm.v, tb_conv1_engine_multi.v]
2026-06-20 feat(tb): rewrite conv2 multi TB with random-speed handshake BFM
    Replaces old sequential virtual-conv1/maxpool with autonomous random-speed
    BFMs on conv2's real handshake ports. N=40 bit-exact PASS, 0 protocol
    violations, prod_sat=30 cons_sat=22 (both backpressure directions). Consumer
    MAX_IDLE raised (producer 1024-word burst >> consumer 576 -> needs long naps
    for output-side backpressure).
    [tb_conv2_engine_multi.v]
2026-06-20 feat(tb): rewrite conv1+conv2 integration multi TB (real wire handshake + random BFM)
    conv1.wdone->conv2.prior_wdone and conv2.rdone->conv1.succ_rdone now real
    wires (was fragile SW manual pulse). Boundary random-speed BFMs only.
    Old TB false-passed on X data (Windows-only paths); now N=40 bit-exact PASS,
    0 protocol violations, prod_sat=38 cons_sat=25. Exercises conv1 bank_sel_pipe
    race fix end-to-end under random pacing.
    [tb_conv1_conv2_multi.v]
2026-06-20 fix(tb): ASCII-only $display output (Vivado console garbles non-ASCII)
    Korean/symbol chars in printed strings (단독/통합/도달/포화, ->, x, shared BMG)
    garble in the Vivado xsim console. Converted all $display/$write output to
    ASCII across the conv1/conv2 single+multi suite. Comments left in Korean
    (not output; UTF-8 source compiles fine). Logic unchanged: 6/6 still PASS.
    [tb_conv1_conv2.v, tb_conv1_conv2_multi.v, tb_conv1_engine.v, tb_conv1_engine_multi.v, tb_conv2_engine.v, tb_conv2_engine_multi.v]
2026-06-22 docs: README 최종 업데이트 (현황·DSP·디렉터리 구조 정정)
    - Winograd: 진행 중 → 설계·검증·timing closure 완료 (보드 실측 미수행, latency 추정 ~86/~75ms)
    - DSP 정정: Conv1 18(K9×OCpair2), Conv2 192(OCpair8×IC8×Krow3) = 226/240; Winograd 236/240(184+36+16)
    - 두 동작점(171.42/200MHz) timing-met 명시, PS-PL feed 병목 결론 반영
    - 디렉터리 구조 최신화: TB 실재 반영, core/·archive/ 등 실제 경로/모듈명 정정, 날짜 2026-06-22
2026-06-22 chore: untrack build-output dir (kept on disk, gitignored) + relocate stale docs
    빌드 산출물 디렉터리는 디스크에 유지하되 git 추적에서 제외(.gitignore에 추가). 부수로 WINOGRAD_200MHZ_CLOSURE_PLAN.md → docs/overclock/winograd/, winograd_utilization.png → winograd_utilization_stale.png 이동.
2026-06-22 docs: README 평가 지표 우선순위 정정 (latency > power > resource)
    2위를 Throughput → Power 로 바로잡고 Resource(3위) 추가.
